Ehsu745/AI-gesture-detection-HID-keyboard/images/HW.png

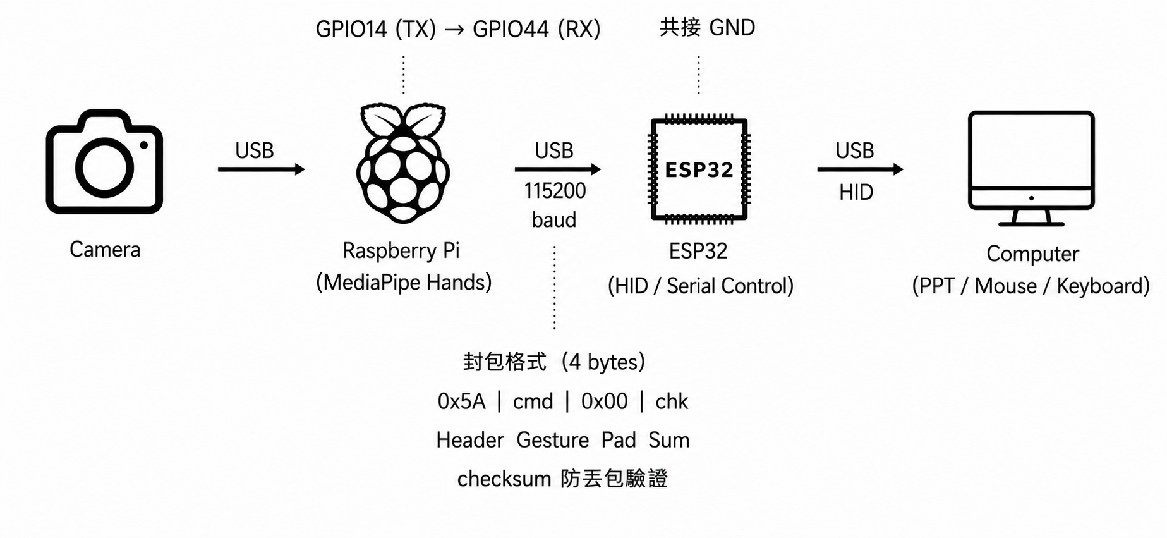
images/HW.png
