Ehsu745/AI-gesture-detection-HID-keyboard/images/SW.png

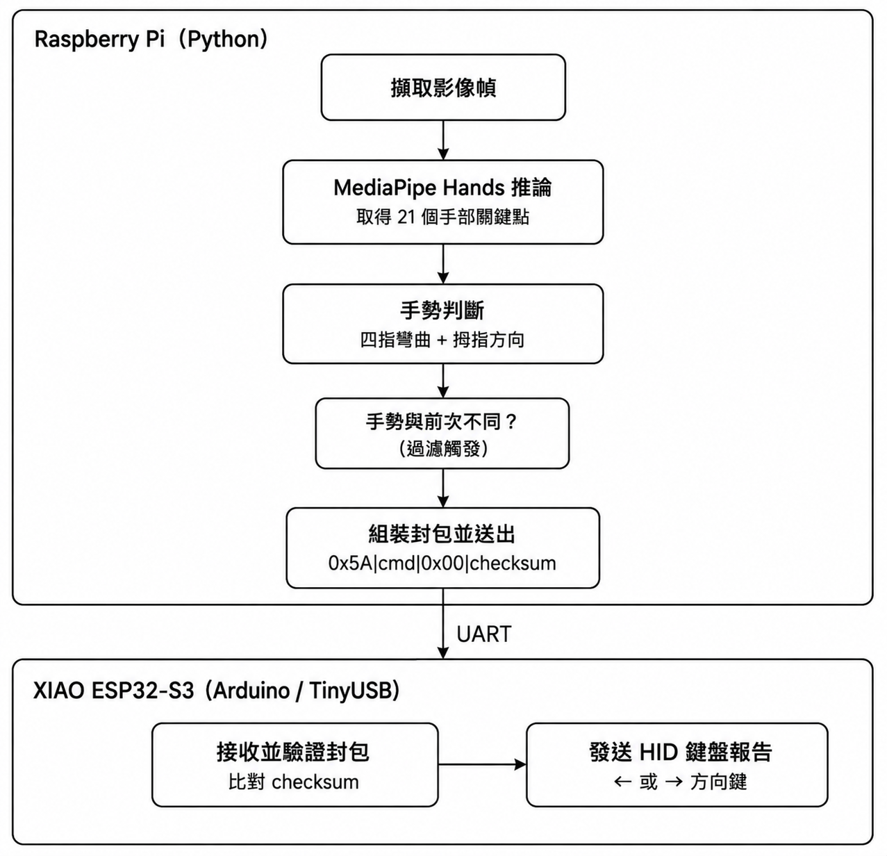
images/SW.png
