Ehsu745/AI-gesture-detection-HID-keyboard/(commit log)

2026-06-13 prototype AI gesture control PPT page Up/Down starting detection through ssh
2026-06-16 newer controller model let user execute gesture camera with a button, and led signal to determine whether the camera is on/off. Finally hold button to turn off RaspberryPi, blink three times before s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
2026-06-16 chore: reorganize repo structure and add missing deployment files.
    [controller.py, gesture_sim.py, main.ino]
2026-08-29 chore: add product photos and enclosure design images, update README to bilingual
2026-08-29 chore: add product photos and enclosure images, update README to bilingual EN/ZH
